sparkfunX/Qwiic_HUD/README.md

# Qwiic_HUD
Qwiic Breakout for the WiseChip US-0011GMIAG01 OLED HUD
