sparkfunX/Qwiic_HUD/Hardware/QwiicHUD.brd

## EAGLE design Hardware/QwiicHUD.brd (2018-04-13)

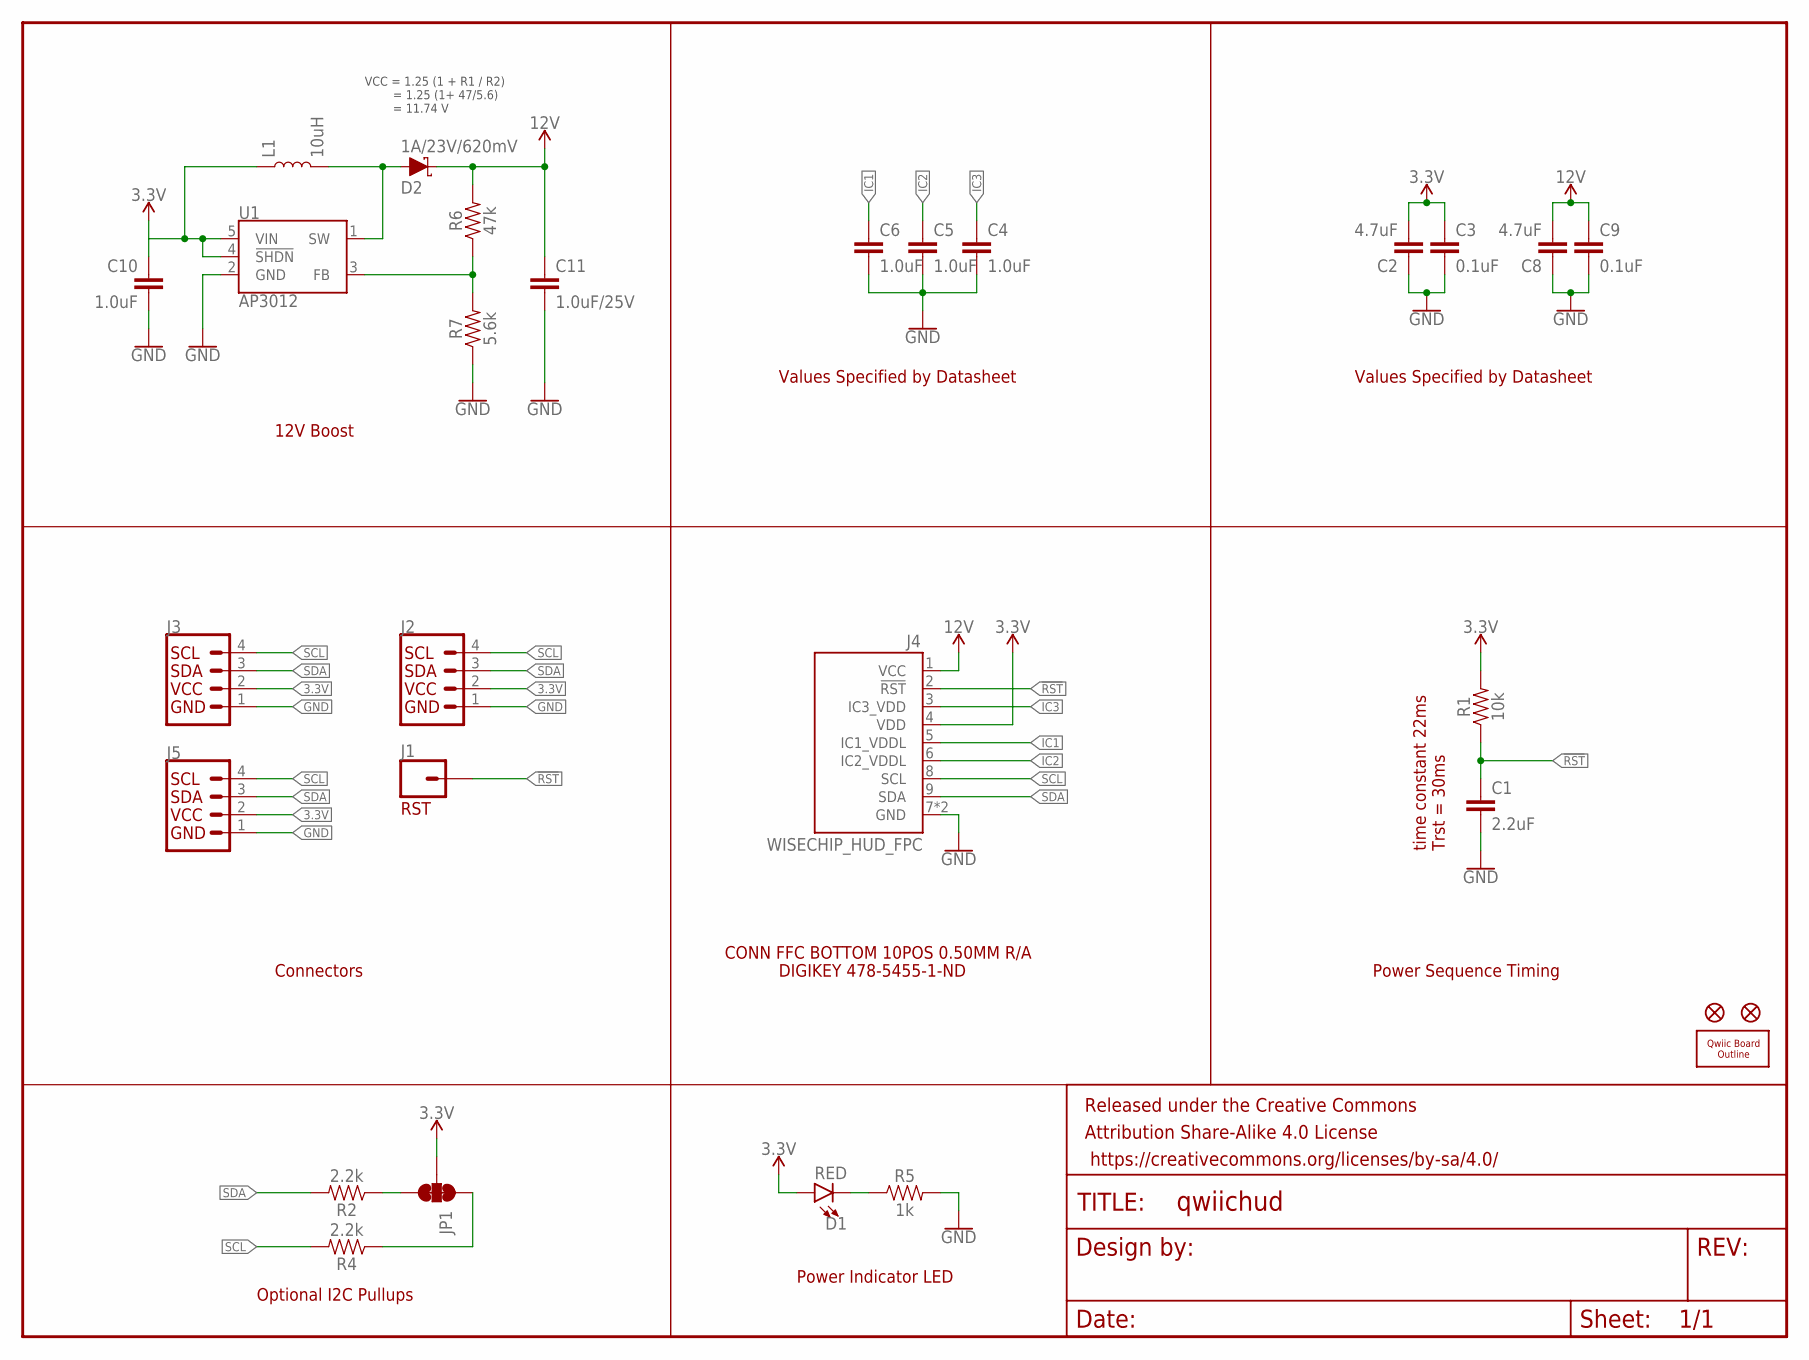
[picture p1: schematic QwiicHUD.sch]

Parts:
C1: 2.2uF; 0603
C2, C8: 4.7uF; 0603
C3, C9: 0.1uF; 0603
C4, C5, C6, C10: 1.0uF; 0603
C11: 1.0uF/25V; 0805
D1: RED; LED-0603
D2: 1A/23V/620mV; SOD-323
FD1, FD2: FIDUCIALUFIDUCIAL; FIDUCIAL-MICRO
FRAME1: FRAME-LETTER; CREATIVE_COMMONS
J1: CONN_01PTH_NO_SILK_YES_STOP; 1X01_NO_SILK
J2: I2C_STANDARD_NO_SILK; 1X04_NO_SILK
J3, J5: I2C_STANDARDJS-1MM; 1X04_1MM_RA
J4: WISECHIP_HUD_FPC; SERIES6288
JP1: JUMPER-SMT_3_2-NC_TRACE_SILK; SMT-JUMPER_3_2-NC_TRACE_SILK
L1: 10uH; INDUCTOR_3X3
R1: 10k; 0603
R2, R4: 2.2k; 0603
R5: 1k; 0603
R6: 47k; 0603
R7: 5.6k; 0603
U1: AP3012; SOT23-5
U$2: QWIIC_BOARD_OUTLINEH; QWIIC_BOARD_MOUNT_HOLES

Connections:
3.3V: C2.2, C3.1, C10.1, D1.A, J2.2 (VCC), J3.2 (VCC), J4.4 (VDD), J5.2 (VCC), JP1.2, L1.P$1 (1), R1.2, U1.4 (!SHDN!), U1.5 (VIN)
12V: C8.2, C9.1, C11.1, D2.C, J4.1 (VCC), R6.2
!RST: C1.1, J1.1, J4.2 (!RST), R1.1
GND: C1.2, C2.1, C3.2, C4.2, C5.2, C6.2, C8.1, C9.2, C10.2, C11.2, J2.1 (GND), J3.1 (GND), J4.7 (GND), J4.10 (GND), J5.1 (GND), R5.2, R7.1, U1.2 (GND)
IC1: C6.1, J4.5 (IC1_VDDL)
IC2: C5.1, J4.6 (IC2_VDDL)
IC3: C4.1, J4.3 (IC3_VDD)
unnamed: JP1.3, R2.1
unnamed: JP1.1, R4.1
unnamed: D1.C, R5.1
unnamed: D2.A, L1.P$2 (2), U1.1 (SW)
unnamed: R6.1, R7.2, U1.3 (FB)
SCL: J2.4 (SCL), J3.4 (SCL), J4.8 (SCL), J5.4 (SCL), R4.2
SDA: J2.3 (SDA), J3.3 (SDA), J4.9 (SDA), J5.3 (SDA), R2.2

Notes on the sheet:
time constant 22ms Trst = 30ms
CONN FFC BOTTOM 10POS 0.50MM R/A
DIGIKEY 478-5455-1-ND
Connectors
Power Sequence Timing
Optional I2C Pullups
Values Specified by Datasheet
RST
Power Indicator LED
VCC = 1.25 (1 + R1 / R2) = 1.25 (1+ 47/5.6) = 11.74 V
12V Boost

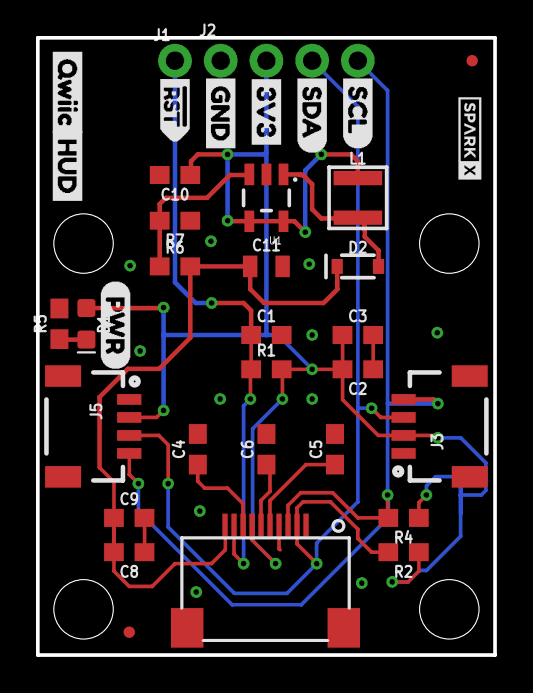
[picture p2: board QwiicHUD.brd from above]

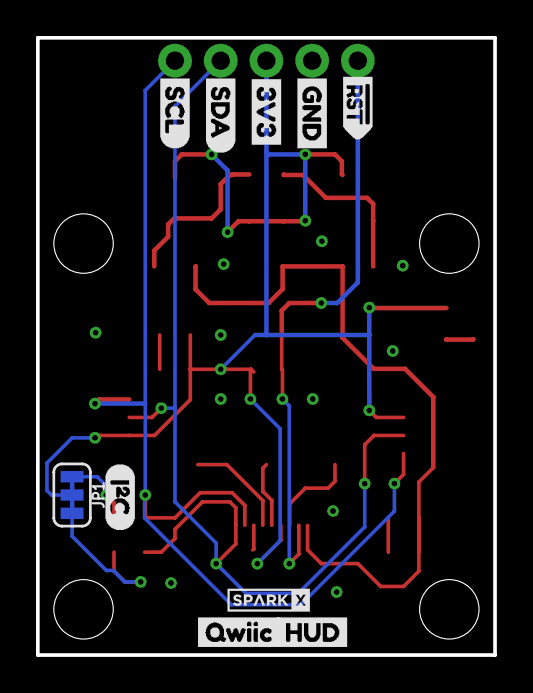
[picture p3: board QwiicHUD.brd from below]

Board: 2 copper layers, 25.4 x 34.3 mm, 48 parts (10 on the bottom side), 14 nets.

Other parts of the board:
U$1, U$14: #RST>
U$3, U$4: SPARKX-TINY
U$5, U$13: GND
U$6, U$12: 3V3
U$7, U$10: SDA
U$8, U$11: SCL
U$9: (PWR)
U$16, U$18: QWIIC0
U$17, U$19: HUD1
U$20: (I_SUPER2_C)
