sparkfunX/Qwiic_HUD/Hardware/Production/QwiicHUD-Panel.brd

## EAGLE design Hardware/Production/QwiicHUD-Panel.brd (2018-08-29)

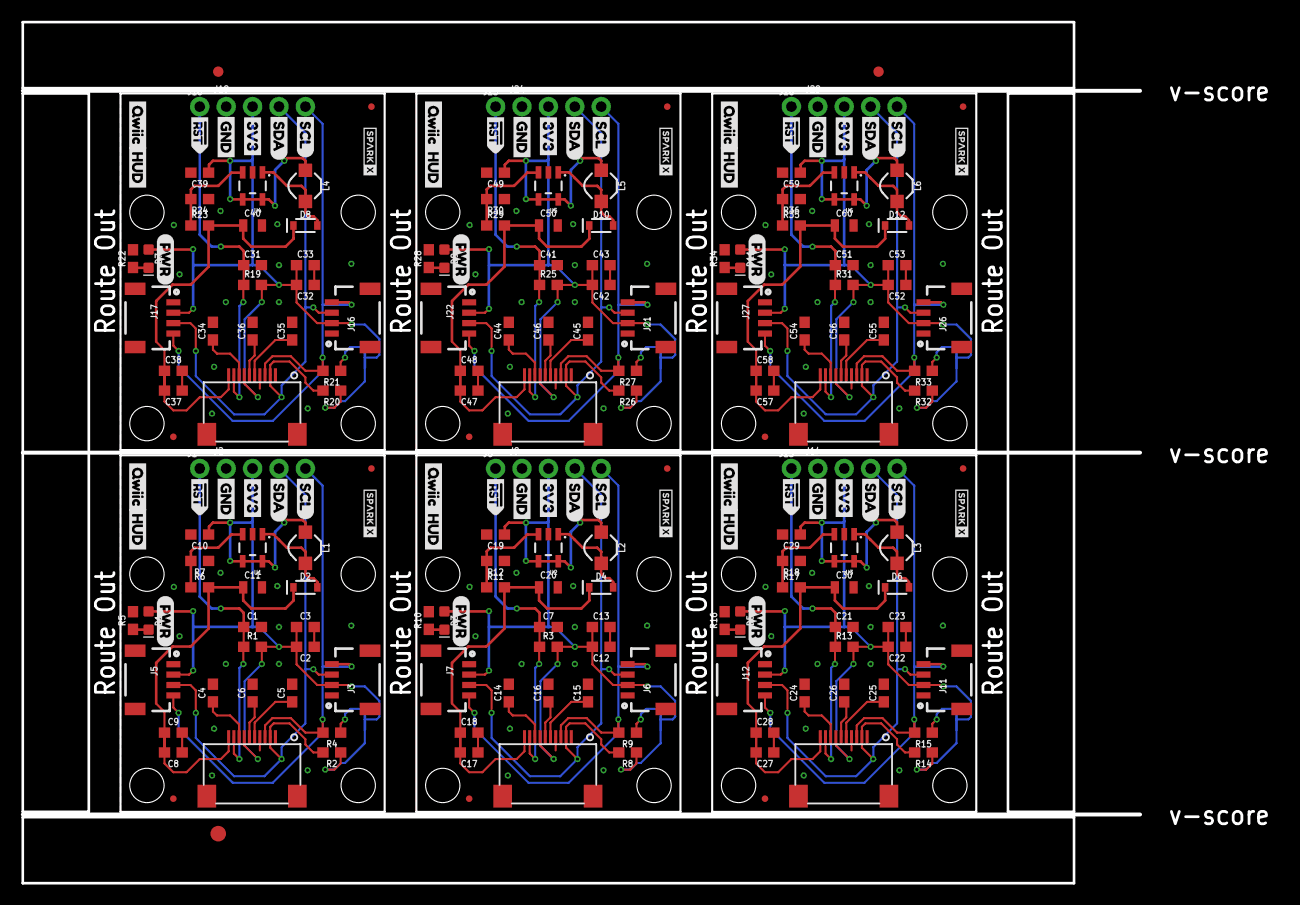
[picture p4: board QwiicHUD-Panel.brd from above]

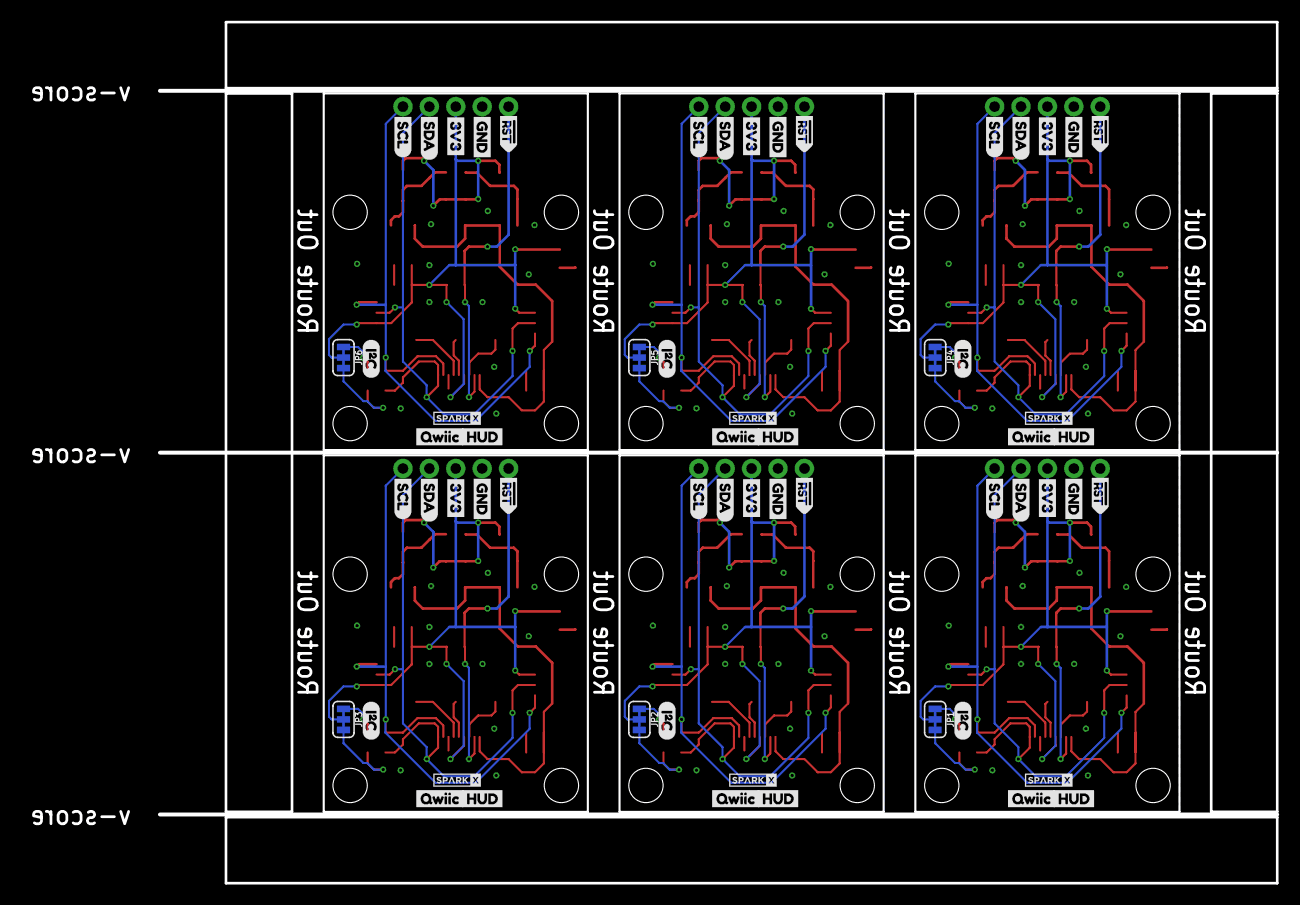
[picture p5: board QwiicHUD-Panel.brd from below]

Board: 2 copper layers, 107.4 x 82.8 mm, 285 parts (60 on the bottom side), 84 nets.

Parts:
C1, C7, C21, C31, C41, C51: 2.2uF; 0603
C2, C8, C12, C17, C22, C27, C32, C37, C42, C47, C52, C57: 4.7uF; 0603
C3, C9, C13, C18, C23, C28, C33, C38, C43, C48, C53, C58: 0.1uF; 0603
C4, C5, C6, C10, C14, C15, C16, C19, C24, C25, C26, C29, C34, C35, C36, C39, C44, C45, C46, C49, C54, C55, C56, C59: 1.0uF; 0603
C11, C20, C30, C40, C50, C60: 1.0uF/25V; 0805
D1, D3, D5, D7, D9, D11: RED; LED-0603
D2, D4, D6, D8, D10, D12: 1A/23V/620mV; SOD-323
E$1, E$2: FIDUCIAL-1X2
E$3: FIDUCIAL-1.5X3
FD1, FD2, FD3, FD4, FD5, FD6, FD7, FD8, FD9, FD10, FD11, FD12: FIDUCIALUFIDUCIAL; FIDUCIAL-MICRO
J1, J8, J13, J18, J23, J28: 1X01_NO_SILK
J2, J9, J14, J19, J24, J29: 1X04_NO_SILK
J3, J5, J6, J7, J11, J12, J16, J17, J21, J22, J26, J27: 1X04_1MM_RA
J4, J10, J15, J20, J25, J30: WISECHIP_HUD_FPC; SERIES6288
JP1, JP2, JP3, JP4, JP5, JP6: SMT-JUMPER_3_2-NC_TRACE_SILK
L1, L2, L3, L4, L5, L6: 10uH; INDUCTOR_4.7UH
R1, R3, R13, R19, R25, R31: 10k; 0603
R2, R4, R8, R9, R14, R15, R20, R21, R26, R27, R32, R33: 2.2k; 0603
R5, R10, R16, R22, R28, R34: 1k; 0603
R6, R11, R17, R23, R29, R35: 47k; 0603
R7, R12, R18, R24, R30, R36: 5.6k; 0603
U1, U2, U3, U4, U5, U6: AP3012; SOT23-5
U$1, U$14, U$23, U$33, U$42, U$52, U$61, U$71, U$80, U$90, U$99, U$109: #RST>
U$2, U$15, U$39, U$58, U$77, U$96: QWIIC_BOARD_OUTLINEH; QWIIC_BOARD_MOUNT_HOLES
U$3, U$4, U$21, U$22, U$40, U$41, U$59, U$60, U$78, U$79, U$97, U$98: SPARKX-TINY
U$5, U$13, U$24, U$32, U$43, U$51, U$62, U$70, U$81, U$89, U$100, U$108: GND
U$6, U$12, U$25, U$31, U$44, U$50, U$63, U$69, U$82, U$88, U$101, U$107: 3V3
U$7, U$10, U$26, U$29, U$45, U$48, U$64, U$67, U$83, U$86, U$102, U$105: SDA
U$8, U$11, U$27, U$30, U$46, U$49, U$65, U$68, U$84, U$87, U$103, U$106: SCL
U$9, U$28, U$47, U$66, U$85, U$104: (PWR)
U$16, U$18, U$34, U$36, U$53, U$55, U$72, U$74, U$91, U$93, U$110, U$112: QWIIC0
U$17, U$19, U$35, U$37, U$54, U$56, U$73, U$75, U$92, U$94, U$111, U$113: HUD1
U$20, U$38, U$57, U$76, U$95, U$114: (I_SUPER2_C)

Connections:
3.3V: C2.2, C3.1, C10.1, D1.A, J2.2, J3.2, J4.4, J5.2, JP1.2, L1.P$1, R1.2, U1.4, U1.5
3.3V1: C12.2, C13.1, C19.1, D3.A, J6.2, J7.2, J9.2, J10.4, JP2.2, L2.P$1, R3.2, U2.4, U2.5
3.3V2: C22.2, C23.1, C29.1, D5.A, J11.2, J12.2, J14.2, J15.4, JP3.2, L3.P$1, R13.2, U3.4, U3.5
3.3V3: C32.2, C33.1, C39.1, D7.A, J16.2, J17.2, J19.2, J20.4, JP4.2, L4.P$1, R19.2, U4.4, U4.5
3.3V4: C42.2, C43.1, C49.1, D9.A, J21.2, J22.2, J24.2, J25.4, JP5.2, L5.P$1, R25.2, U5.4, U5.5
3.3V5: C52.2, C53.1, C59.1, D11.A, J26.2, J27.2, J29.2, J30.4, JP6.2, L6.P$1, R31.2, U6.4, U6.5
12V: C8.2, C9.1, C11.1, D2.C, J4.1, R6.2
12V1: C17.2, C18.1, C20.1, D4.C, J10.1, R11.2
12V2: C27.2, C28.1, C30.1, D6.C, J15.1, R17.2
12V3: C37.2, C38.1, C40.1, D8.C, J20.1, R23.2
12V4: C47.2, C48.1, C50.1, D10.C, J25.1, R29.2
12V5: C57.2, C58.1, C60.1, D12.C, J30.1, R35.2
!RST: C1.1, J1.1, J4.2, R1.1
!RST1: C7.1, J8.1, J10.2, R3.1
!RST2: C21.1, J13.1, J15.2, R13.1
!RST3: C31.1, J18.1, J20.2, R19.1
!RST4: C41.1, J23.1, J25.2, R25.1
!RST5: C51.1, J28.1, J30.2, R31.1
GND: C1.2, C2.1, C3.2, C4.2, C5.2, C6.2, C8.1, C9.2, C10.2, C11.2, J2.1, J3.1, J4.7, J4.10, J5.1, R5.2, R7.1, U1.2
GND1: C7.2, C12.1, C13.2, C14.2, C15.2, C16.2, C17.1, C18.2, C19.2, C20.2, J6.1, J7.1, J9.1, J10.7, J10.10, R10.2, R12.1, U2.2
GND2: C21.2, C22.1, C23.2, C24.2, C25.2, C26.2, C27.1, C28.2, C29.2, C30.2, J11.1, J12.1, J14.1, J15.7, J15.10, R16.2, R18.1, U3.2
GND3: C31.2, C32.1, C33.2, C34.2, C35.2, C36.2, C37.1, C38.2, C39.2, C40.2, J16.1, J17.1, J19.1, J20.7, J20.10, R22.2, R24.1, U4.2
GND4: C41.2, C42.1, C43.2, C44.2, C45.2, C46.2, C47.1, C48.2, C49.2, C50.2, J21.1, J22.1, J24.1, J25.7, J25.10, R28.2, R30.1, U5.2
GND5: C51.2, C52.1, C53.2, C54.2, C55.2, C56.2, C57.1, C58.2, C59.2, C60.2, J26.1, J27.1, J29.1, J30.7, J30.10, R34.2, R36.1, U6.2
IC1: C6.1, J4.5
IC2: C5.1, J4.6
IC3: C4.1, J4.3
IC4: C14.1, J10.3
IC5: C16.1, J10.5
IC6: C15.1, J10.6
IC7: C24.1, J15.3
IC8: C26.1, J15.5
IC9: C25.1, J15.6
IC10: C34.1, J20.3
IC11: C36.1, J20.5
IC12: C35.1, J20.6
IC13: C44.1, J25.3
IC14: C46.1, J25.5
IC15: C45.1, J25.6
IC16: C54.1, J30.3
IC17: C56.1, J30.5
IC18: C55.1, J30.6
unnamed: JP1.3, R2.1
unnamed: JP1.1, R4.1
unnamed: D1.C, R5.1
unnamed: D2.A, L1.P$2, U1.1
unnamed: R6.1, R7.2, U1.3
unnamed: JP2.3, R8.1
unnamed: JP2.1, R9.1
unnamed: D3.C, R10.1
unnamed: D4.A, L2.P$2, U2.1
unnamed: R11.1, R12.2, U2.3
unnamed: JP3.3, R14.1
unnamed: JP3.1, R15.1
unnamed: D5.C, R16.1
unnamed: D6.A, L3.P$2, U3.1
unnamed: R17.1, R18.2, U3.3
unnamed: JP4.3, R20.1
unnamed: JP4.1, R21.1
unnamed: D7.C, R22.1
unnamed: D8.A, L4.P$2, U4.1
unnamed: R23.1, R24.2, U4.3
unnamed: JP5.3, R26.1
unnamed: JP5.1, R27.1
unnamed: D9.C, R28.1
unnamed: D10.A, L5.P$2, U5.1
unnamed: R29.1, R30.2, U5.3
unnamed: JP6.3, R32.1
unnamed: JP6.1, R33.1
unnamed: D11.C, R34.1
unnamed: D12.A, L6.P$2, U6.1
unnamed: R35.1, R36.2, U6.3
SCL: J2.4, J3.4, J4.8, J5.4, R4.2
SCL1: J6.4, J7.4, J9.4, J10.8, R9.2
SCL2: J11.4, J12.4, J14.4, J15.8, R15.2
SCL3: J16.4, J17.4, J19.4, J20.8, R21.2
SCL4: J21.4, J22.4, J24.4, J25.8, R27.2
SCL5: J26.4, J27.4, J29.4, J30.8, R33.2
SDA: J2.3, J3.3, J4.9, J5.3, R2.2
SDA1: J6.3, J7.3, J9.3, J10.9, R8.2
SDA2: J11.3, J12.3, J14.3, J15.9, R14.2
SDA3: J16.3, J17.3, J19.3, J20.9, R20.2
SDA4: J21.3, J22.3, J24.3, J25.9, R26.2
SDA5: J26.3, J27.3, J29.3, J30.9, R32.2
