sparkfunX/Qwiic_HUD/Hardware/Production/ordering_instructions.txt

panel size, 102x83mm
PCB thickness, 1.6mm
number of layers, 2
soldermask color, Black
silkscreen color, White
oz copper, 1oz
finish, HASL lead free
stencils, bottom
pcs per panel, 6
