sparkfunX/Qwiic_HUD/(commit log)

2018-04-13 x02
    Added 12V boost circuit
    [QwiicHUD-Panel.GBL, QwiicHUD-Panel.GBO, QwiicHUD-Panel.GBS, QwiicHUD-Panel.GKO, QwiicHUD-Panel.GTL, QwiicHUD-Panel.GTO, QwiicHUD-Panel.GTP, QwiicHUD-Panel.GTS]
2018-04-20 Cleaning Up
    [QwiicHUD-Panel.GBL, QwiicHUD-Panel.GBO, QwiicHUD-Panel.GBS, QwiicHUD-Panel.GKO, QwiicHUD-Panel.GTL, QwiicHUD-Panel.GTO, QwiicHUD-Panel.GTP, QwiicHUD-Panel.GTS]
2018-04-20 Adding a PDF of the schematic
2018-08-29 Changed inductor to inventory part
    [QwiicHUD-Panel.GBL, QwiicHUD-Panel.GBO, QwiicHUD-Panel.GBS, QwiicHUD-Panel.GKO, QwiicHUD-Panel.GTL, QwiicHUD-Panel.GTO, QwiicHUD-Panel.GTP, QwiicHUD-Panel.GTS]
